hanshuebner/OpenC16Cart/doc/render-bottom.png

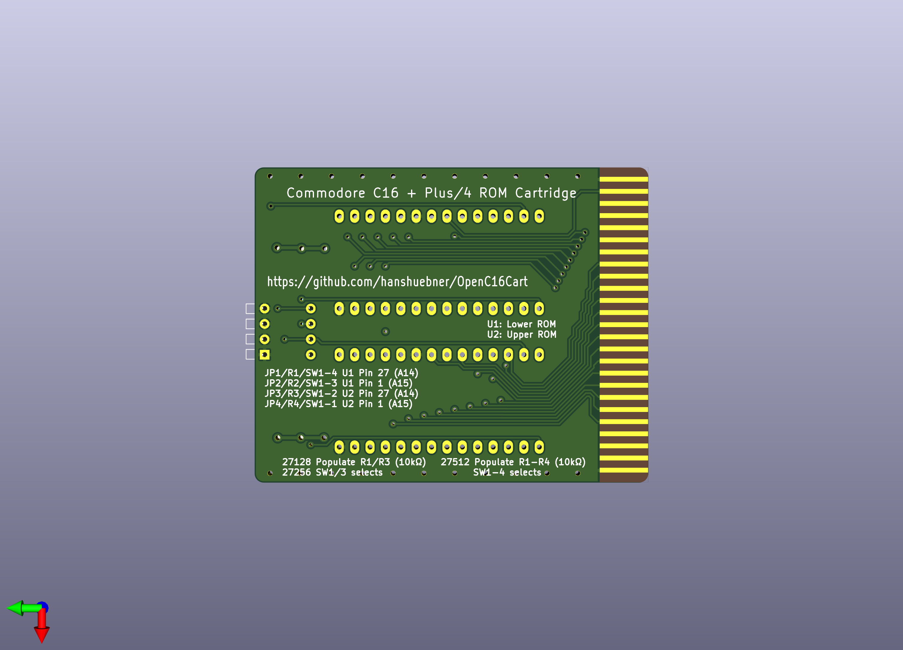
doc/render-bottom.png
