hanshuebner/OpenC16Cart/doc/schematic.pdf

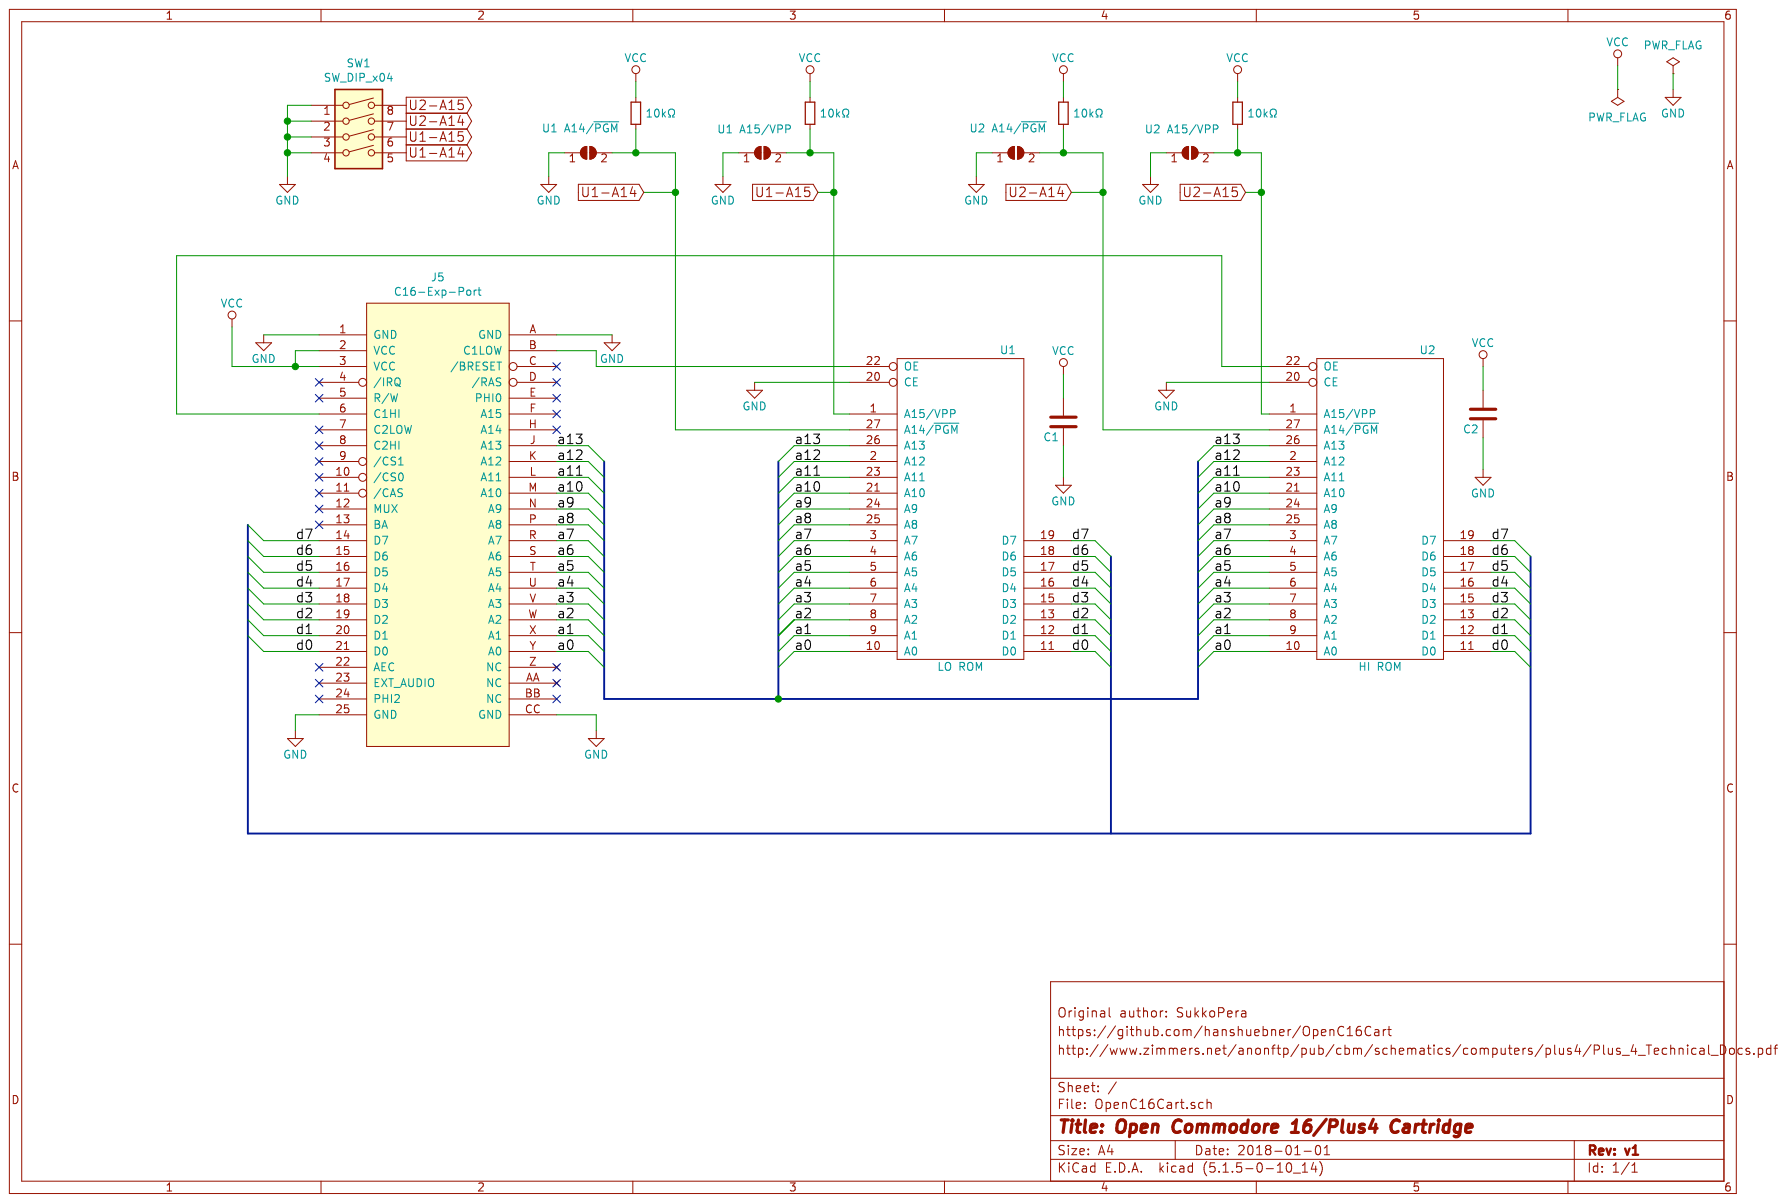
[picture p3: page 1]
