hanshuebner/OpenC16Cart/OpenC16Cart.kicad_pcb

## KiCad design OpenC16Cart.kicad_pcb (2020-07-12)

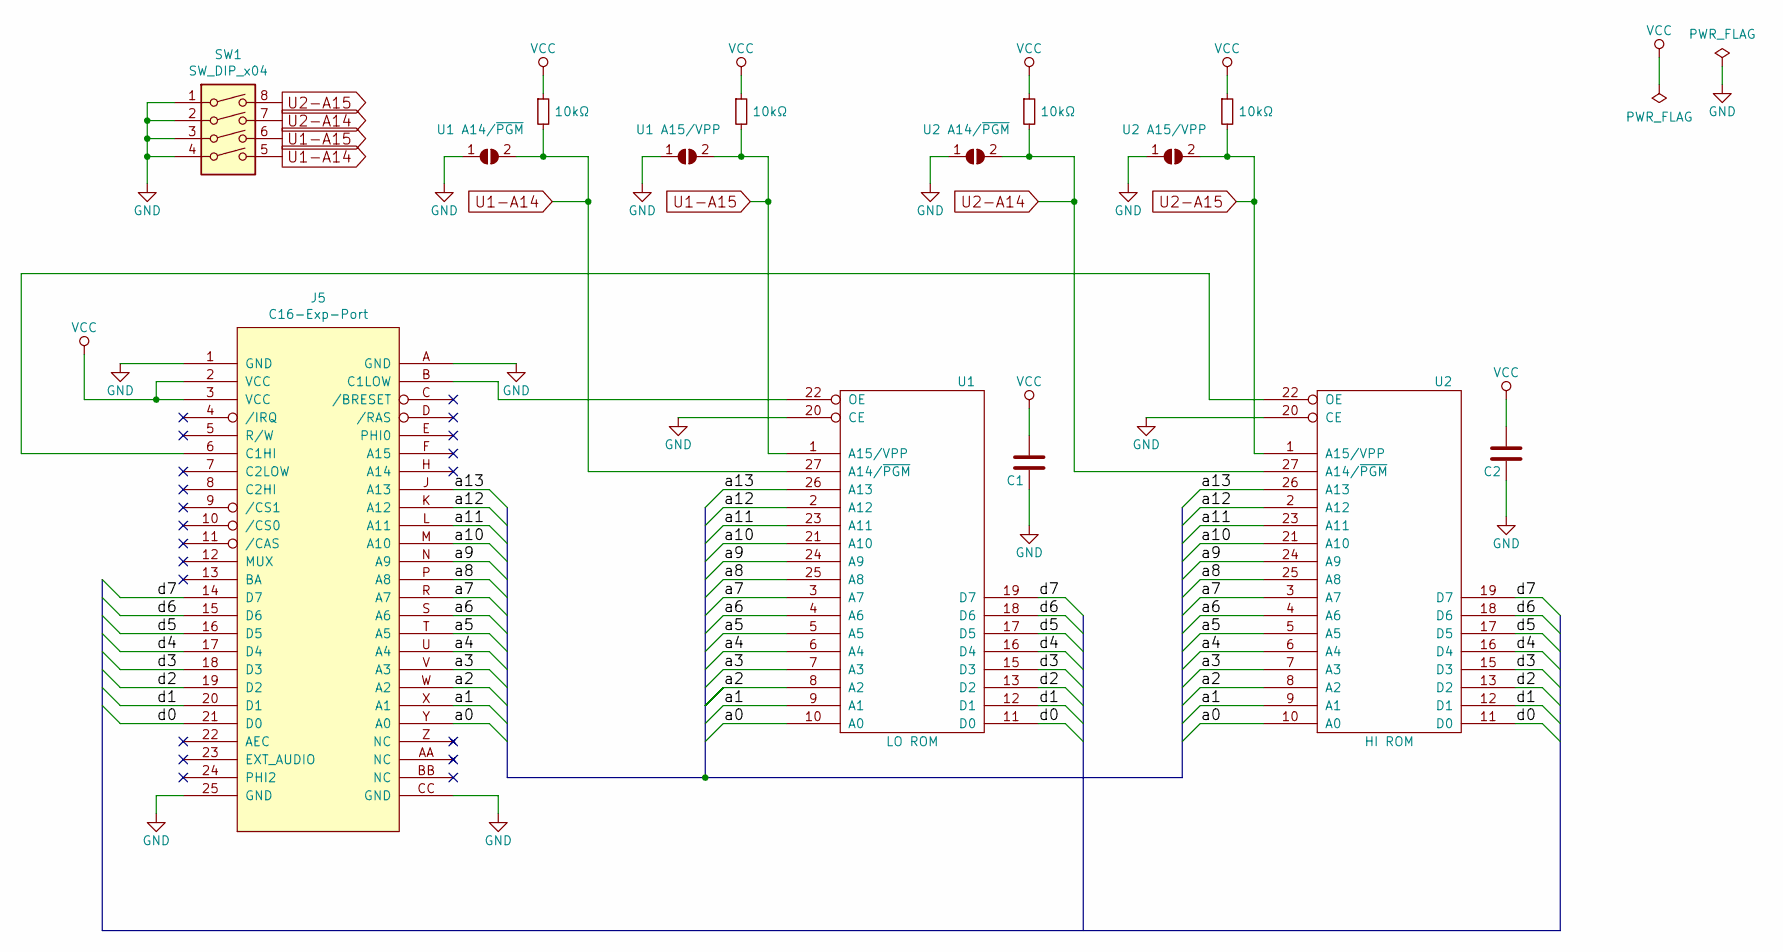
[picture p4: schematic OpenC16Cart.sch, Open Commodore 16/Plus4 Cartridge]

Parts:
C1, C2: C; C_0805_HandSoldering
J5: C16-Exp-Port; C16_Cart_Conn
JP1: U1 A14/~PGM; SolderJumper-2_P1.3mm_Open_RoundedPad1.0x1.5mm
JP2: U1 A15/VPP; SolderJumper-2_P1.3mm_Open_RoundedPad1.0x1.5mm
JP3: U2 A14/~PGM; SolderJumper-2_P1.3mm_Open_RoundedPad1.0x1.5mm
JP4: U2 A15/VPP; SolderJumper-2_P1.3mm_Open_RoundedPad1.0x1.5mm
R1, R2, R3, R4: 10kΩ; R_0805_2012Metric_Pad1.15x1.40mm_HandSolder
SW1: SW_DIP_x04; SW_DIP_SPSTx04_Piano_10.8x11.72mm_W7.62mm_P2.54mm
U1: LO ROM; dil_28-600_socket_ThinSilkS
U2: HI ROM; dil_28-600_socket_ThinSilkS

Connections:
/a0: J5.Y (A0), U1.10 (A0), U2.10 (A0)
/a1: J5.X (A1), U1.9 (A1), U2.9 (A1)
/a2: J5.W (A2), U1.8 (A2), U2.8 (A2)
/a3: J5.V (A3), U1.7 (A3), U2.7 (A3)
/a4: J5.U (A4), U1.6 (A4), U2.6 (A4)
/a5: J5.T (A5), U1.5 (A5), U2.5 (A5)
/a6: J5.S (A6), U1.4 (A6), U2.4 (A6)
/a7: J5.R (A7), U1.3 (A7), U2.3 (A7)
/a8: J5.P (A8), U1.25 (A8), U2.25 (A8)
/a9: J5.N (A9), U1.24 (A9), U2.24 (A9)
/a10: J5.M (A10), U1.21 (A10), U2.21 (A10)
/a11: J5.L (A11), U1.23 (A11), U2.23 (A11)
/a12: J5.K (A12), U1.2 (A12), U2.2 (A12)
/a13: J5.J (A13), U1.26 (A13), U2.26 (A13)
/d0: J5.21 (D0), U1.11 (D0), U2.11 (D0)
/d1: J5.20 (D1), U1.12 (D1), U2.12 (D1)
/d2: J5.19 (D2), U1.13 (D2), U2.13 (D2)
/d3: J5.18 (D3), U1.15 (D3), U2.15 (D3)
/d4: J5.17 (D4), U1.16 (D4), U2.16 (D4)
/d5: J5.16 (D5), U1.17 (D5), U2.17 (D5)
/d6: J5.15 (D6), U1.18 (D6), U2.18 (D6)
/d7: J5.14 (D7), U1.19 (D7), U2.19 (D7)
GND: C1.1, C2.1, J5.1 (GND), J5.25 (GND), J5.A (GND), J5.CC (GND), JP1.1 (A), JP2.1 (A), JP3.1 (A), JP4.1 (A), SW1.1, SW1.2, SW1.3, SW1.4, U1.14 (GND), U1.20 (CE), U2.14 (GND), U2.20 (CE)
unnamed: J5.6 (C1HI), U2.22 (OE)
unnamed: J5.B (C1LOW), U1.22 (OE)
U1-A14: JP1.2 (B), R1.2, SW1.5, U1.27 (A14/~PGM)
U1-A15: JP2.2 (B), R2.2, SW1.6, U1.1 (A15/VPP)
U2-A14: JP3.2 (B), R3.2, SW1.7, U2.27 (A14/~PGM)
U2-A15: JP4.2 (B), R4.2, SW1.8, U2.1 (A15/VPP)
VCC: C1.2, C2.2, J5.2 (VCC), J5.3 (VCC), R1.1, R2.1, R3.1, R4.1, U1.28 (VCC), U2.28 (VCC)

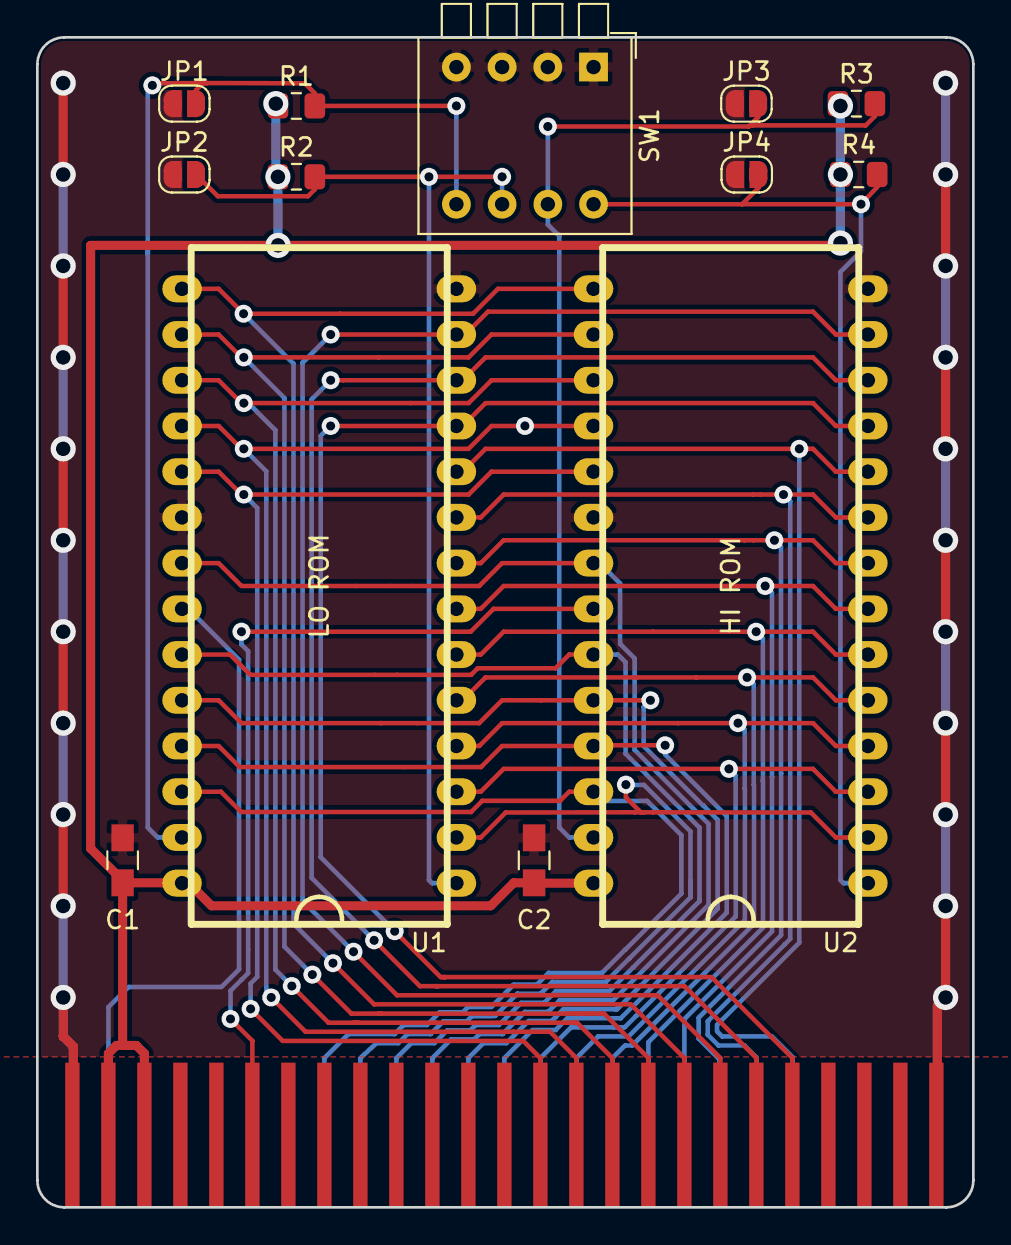
[picture p5: board OpenC16Cart.kicad_pcb from above]

Board: 2 copper layers, 52.0 x 65.0 mm, 14 parts (0 on the bottom side), 30 nets.
