hanshuebner/OpenC16Cart/(commit log)

2020-07-12 Layout redone, schematics simplified
    [OpenC16Cart.kicad_pcb, OpenC16Cart.sch]
2020-07-12 Generate production gerbers
    [OpenC16Cart-B_Cu.gbr, OpenC16Cart-B_Mask.gbr, OpenC16Cart-B_SilkS.gbr, OpenC16Cart-Edge_Cuts.gbr, OpenC16Cart-F_Cu.gbr, OpenC16Cart-F_Mask.gbr, OpenC16Cart-F_SilkS.gbr, OpenC16Cart-NPTH.drl]
